TannerAWilliams/Senior-Design-Project/Rev2.1/cc2650_rev2-1_schematic.pdf

# Reset Button JTAG Connection

# MCU & Pins

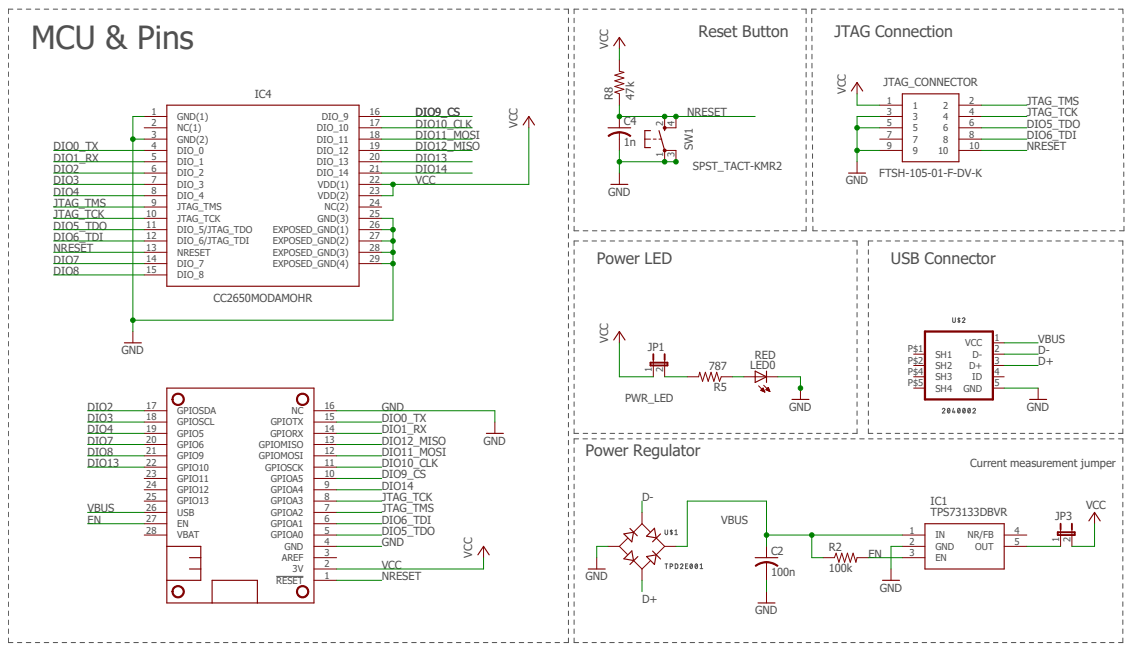
[picture p7: page 1]

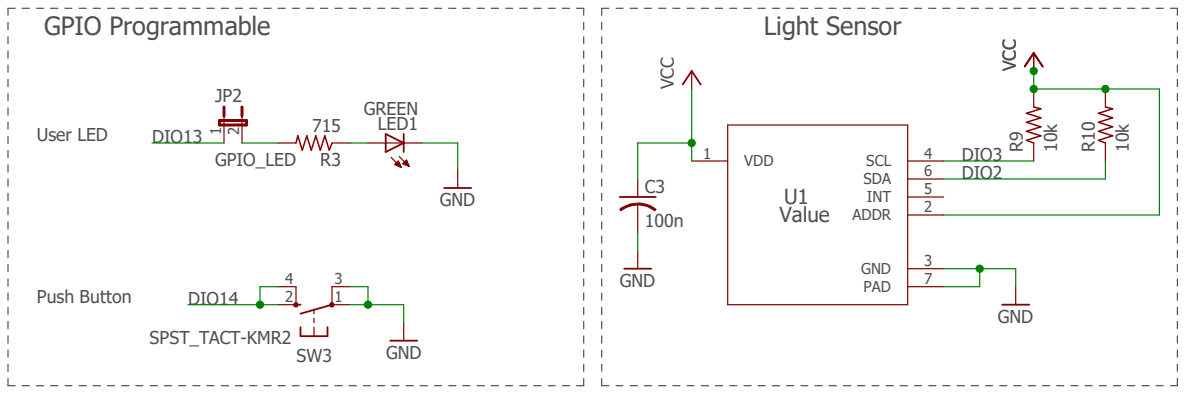
[picture p8: figure]
SPST_TACT-KMR2; GND; GPIO_LED; Value; GND VCC; VCC; GREEN; GPIO Programmable; User LED; Light Sensor; Push Button; VDD 1; ADDR; SCL; INT; 5 SDA; 6 PAD; LED1; R¹⁰; DIO14; DIO13; DIO3 DIO2
