TannerAWilliams/Senior-Design-Project/Rev1.2/cc2650_rev1-2_schematic.pdf

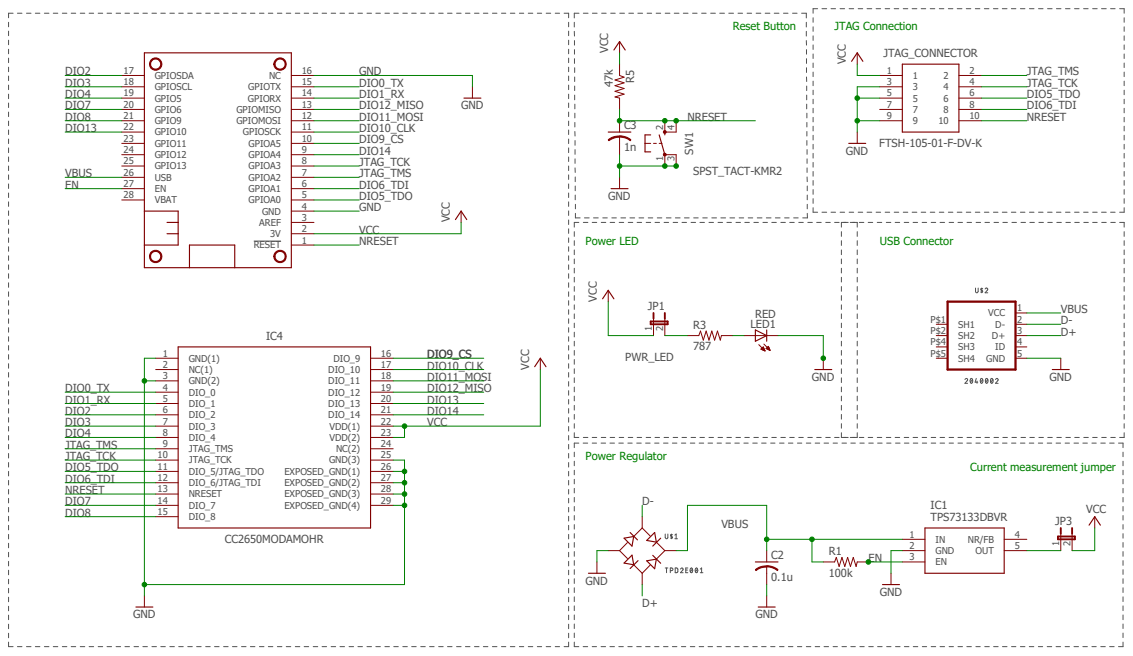
[picture p9: page 1]

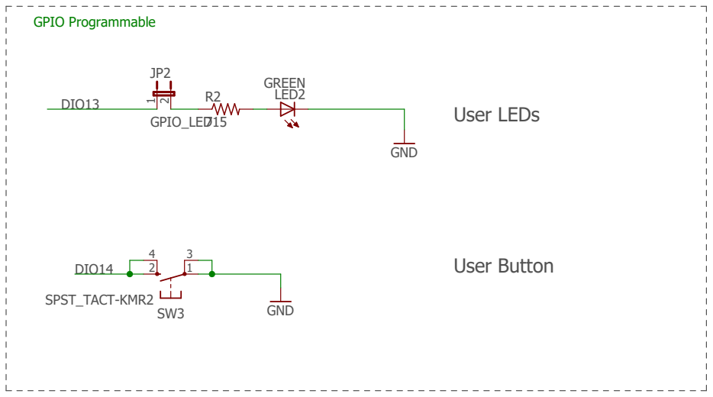
[picture p10: figure]
SPST_TACT-KMR2; GND; GREEN; GPIO_LED; User LEDs; User Button; LED2 1; DIO14; DIO13; GPIO Programmable
