TannerAWilliams/Senior-Design-Project/Rev1.0/cc2650_rev1_schematic.pdf

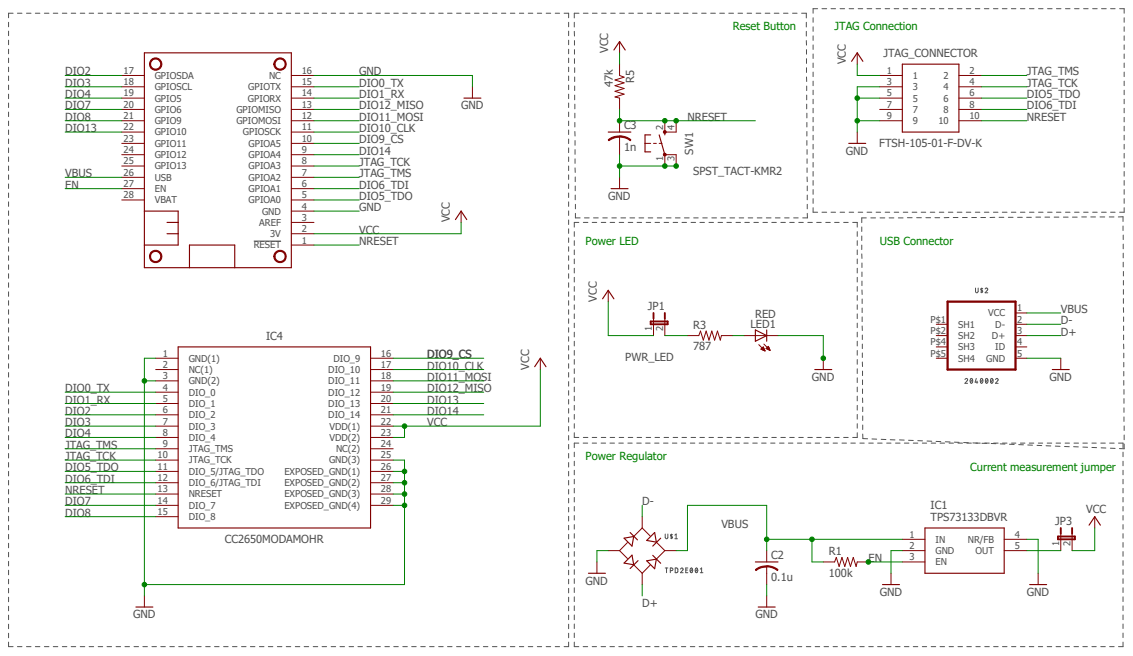
[picture p11: page 1]

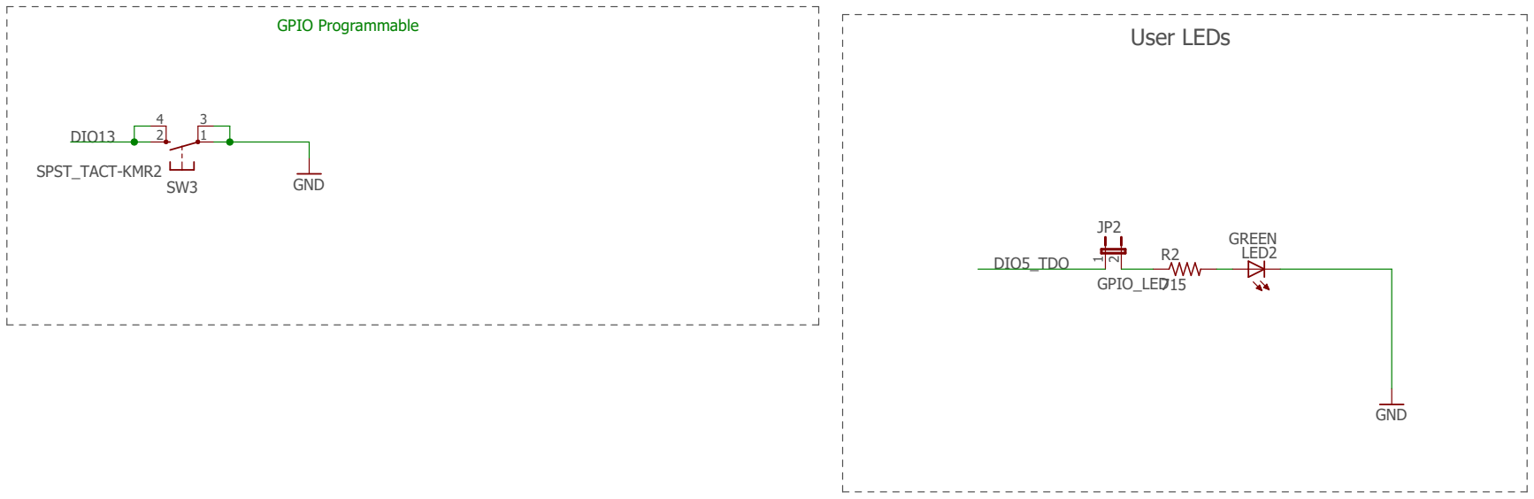
[picture p12: figure]
SPST_TACT-KMR2; GND; GREEN; GPIO_LED; User LEDs; LED2 1; DIO5_TDO; DIO13; GPIO Programmable
