TannerAWilliams/Senior-Design-Project/Rev1.1/cc2650_rev1-1_schematic.pdf

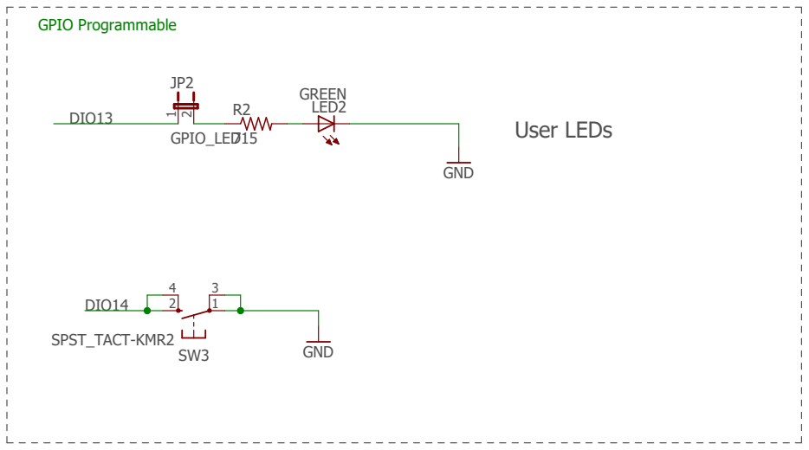
[picture p13: figure]
SPST_TACT-KMR2; GND; GREEN; GPIO_LED; User LEDs; LED2 1; DIO14; DIO13; GPIO Programmable
