TannerAWilliams/Senior-Design-Project/Rev1.2/cc2650_rev1-2.brd

## EAGLE design Rev1.2/cc2650_rev1-2.brd (2018-04-23, an earlier design)

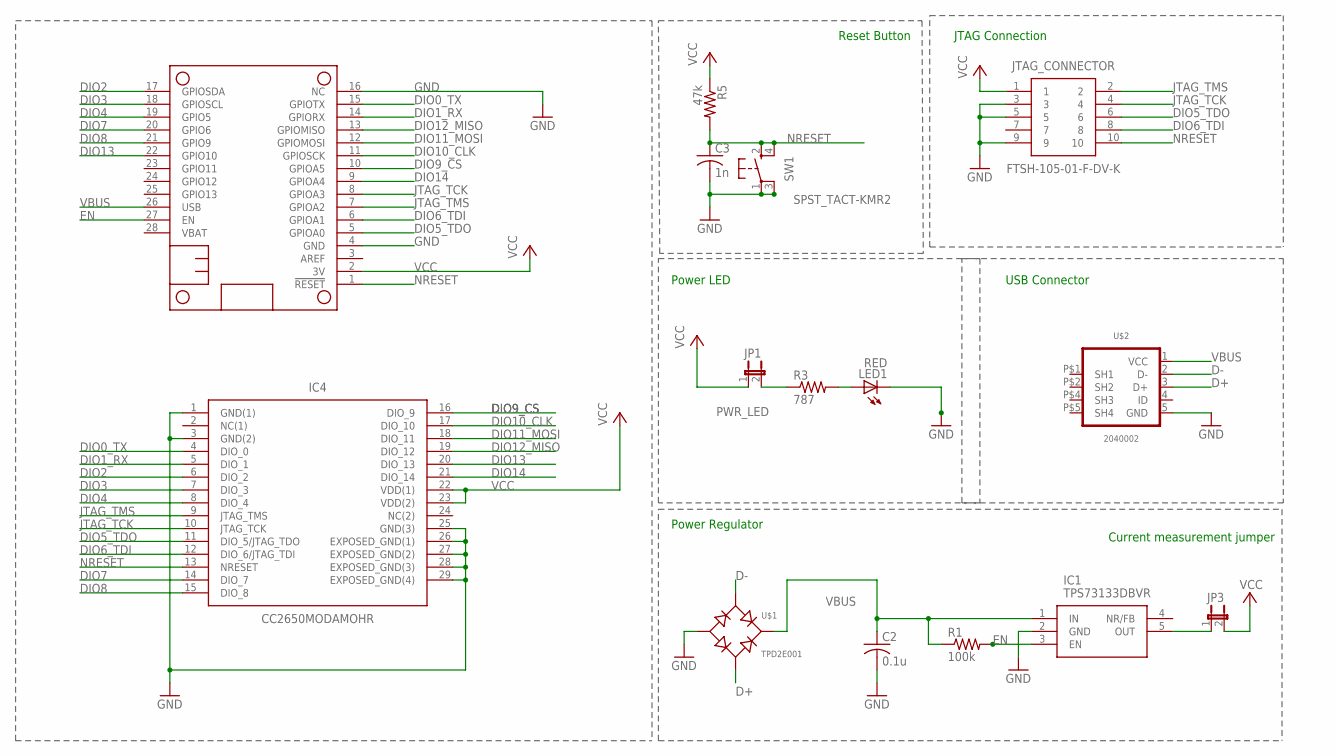
[picture p14: schematic cc2650_rev1-2.sch, sheet 1]

Parts:
C2: 0.1u; C1206; MPN VJ1206Y102KXBAC
C3: 1n; C1206; MPN VJ1206Y102KXBAC
IC1: TPS73133DBVR; SOT95P280X145-5N; MPN TPS73133DBVR
IC4: CC2650MODAMOHR; MOH0029A; MPN CC2650MODAMOHR
JP1, JP3: PWR_LED; JP1M; MPN 2211S-02G
JTAG_CONNECTOR: FTSH-105-01-F-DV-K; SAMTEC_FTSH-105-01-L-DV; MPN FTSH-105-01-F-DV-K
LED1: RED; CHIPLED_1206; MPN HSMC-C150
MS1: FEATHERWING_NODIM; FEATHERWING_DIM
R1: 100k; R1206; MPN CR1206-FX-4700ELF
R3: 787; R1206; MPN CR1206-FX-4700ELF
R5: 47k; R1206; MPN CRCW120647K0FKTA
SW1: SPST_TACT-KMR2; KMR2; MPN KMR241G LFS
U$1: TPD2E001; SOT-143
U$2: 2040002

Connections:
D+: U$1.3 (AC2), U$2.3 (D+)
D-: U$1.2 (AC1), U$2.2 (D-)
DIO0_TX: IC4.4 (DIO_0), MS1.15 (GPIOTX)
DIO1_RX: IC4.5 (DIO_1), MS1.14 (GPIORX)
DIO2: IC4.6 (DIO_2), MS1.17 (GPIOSDA)
DIO3: IC4.7 (DIO_3), MS1.18 (GPIOSCL)
DIO4: IC4.8 (DIO_4), MS1.19 (GPIO5)
DIO5_TDO: IC4.11 (DIO_5/JTAG_TDO), JTAG_CONNECTOR.6, MS1.5 (GPIOA0)
DIO6_TDI: IC4.12 (DIO_6/JTAG_TDI), JTAG_CONNECTOR.8, MS1.6 (GPIOA1)
DIO7: IC4.14 (DIO_7), MS1.20 (GPIO6)
DIO8: IC4.15 (DIO_8), MS1.21 (GPIO9)
DIO9_CS: IC4.16 (DIO_9), MS1.10 (GPIOA5)
DIO10_CLK: IC4.17 (DIO_10), MS1.11 (GPIOSCK)
DIO11_MOSI: IC4.18 (DIO_11), MS1.12 (GPIOMOSI)
DIO12_MISO: IC4.19 (DIO_12), MS1.13 (GPIOMISO)
DIO13: IC4.20 (DIO_13), MS1.22 (GPIO10); also elsewhere on the board
DIO14: IC4.21 (DIO_14), MS1.9 (GPIOA4); also elsewhere on the board
EN: IC1.3 (EN), MS1.27 (EN), R1.2
GND: C2.2, C3.2, IC1.2 (GND), IC4.1 (GND(1)), IC4.3 (GND(2)), IC4.25 (GND(3)), IC4.26 (EXPOSED_GND(1)), IC4.27 (EXPOSED_GND(2)), IC4.28 (EXPOSED_GND(3)), IC4.29 (EXPOSED_GND(4)), JTAG_CONNECTOR.3, JTAG_CONNECTOR.5, JTAG_CONNECTOR.9, LED1.C, MS1.4 (GND), MS1.16 (NC), SW1.1, SW1.3 (P1), U$1.1 (-), U$2.5 (GND); also elsewhere on the board
JTAG_TCK: IC4.10 (JTAG_TCK), JTAG_CONNECTOR.4, MS1.8 (GPIOA3)
JTAG_TMS: IC4.9 (JTAG_TMS), JTAG_CONNECTOR.2, MS1.7 (GPIOA2)
NRESET: C3.1, IC4.13 (NRESET), JTAG_CONNECTOR.10, MS1.1 (!RESET), R5.2, SW1.2 (S), SW1.4 (S1)
PWR_LED: LED1.A, R3.2
PWR_LED_JPR: JP1.2, R3.1
VBUS: C2.1, IC1.1 (IN), MS1.26 (USB), R1.1, U$1.4 (+), U$2.1 (VCC)
VCC: IC4.22 (VDD(1)), IC4.23 (VDD(2)), JP1.1, JP3.2, JTAG_CONNECTOR.1, MS1.2 (3V), R5.1
VCC_JPR: IC1.5 (OUT), JP3.1

Notes on the sheet:
Current measurement jumper
JTAG Connection
Reset Button
Power Regulator
Power LED
USB Connector

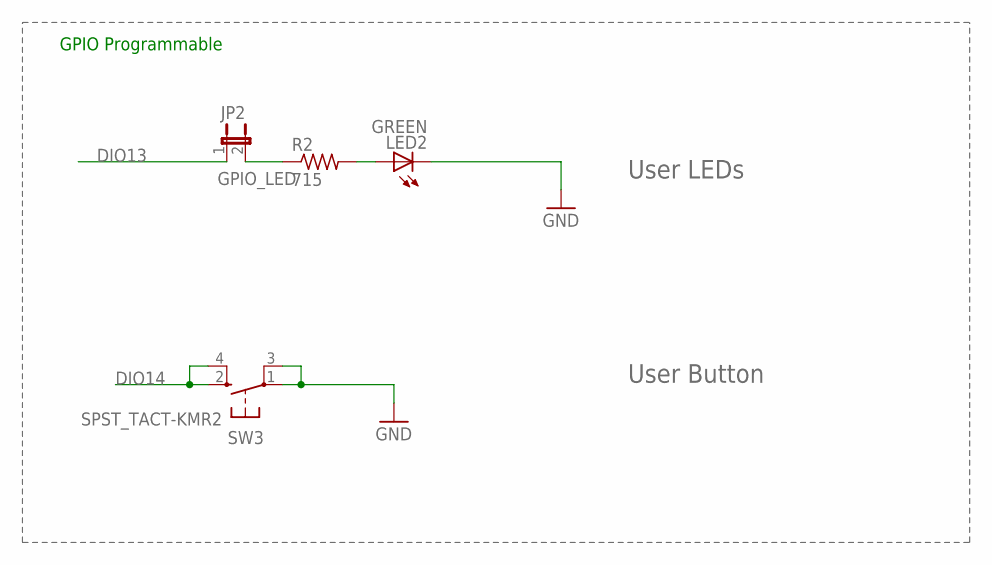
[picture p15: schematic cc2650_rev1-2.sch, sheet 2]

Parts:
JP2: GPIO_LED; JP1M; MPN 2211S-02G
LED2: GREEN; CHIPLED_1206; MPN HSMC-C150
R2: 715; R1206; MPN CR1206-FX-4700ELF
SW3: SPST_TACT-KMR2; KMR2; MPN KMR241G LFS

Connections:
DIO13: JP2.1; also elsewhere on the board
DIO14: SW3.2 (S), SW3.4 (S1); also elsewhere on the board
GND: LED2.C, SW3.1, SW3.3 (P1); also elsewhere on the board
GPIO_LED: LED2.A, R2.2
GPIO_LED_JPR: JP2.2, R2.1

Notes on the sheet:
GPIO Programmable
User LEDs
User Button

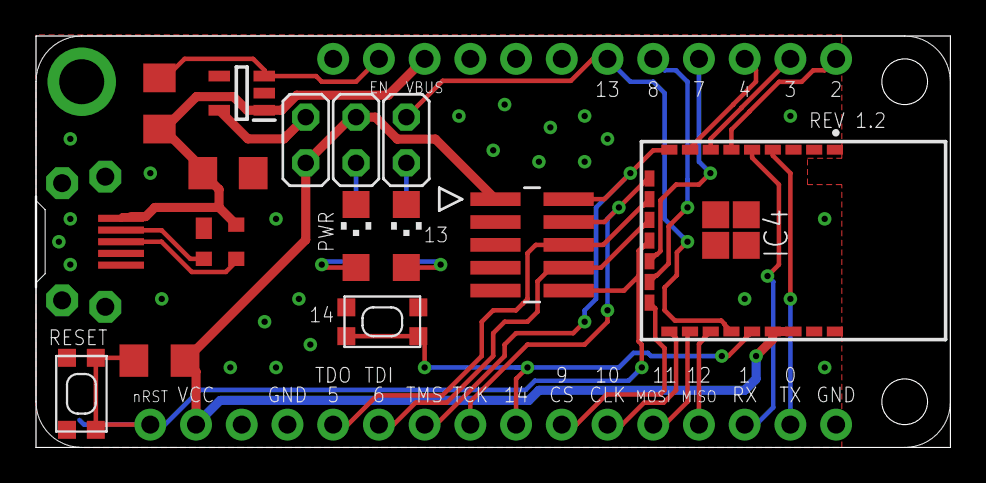
[picture p16: board cc2650_rev1-2.brd from above]

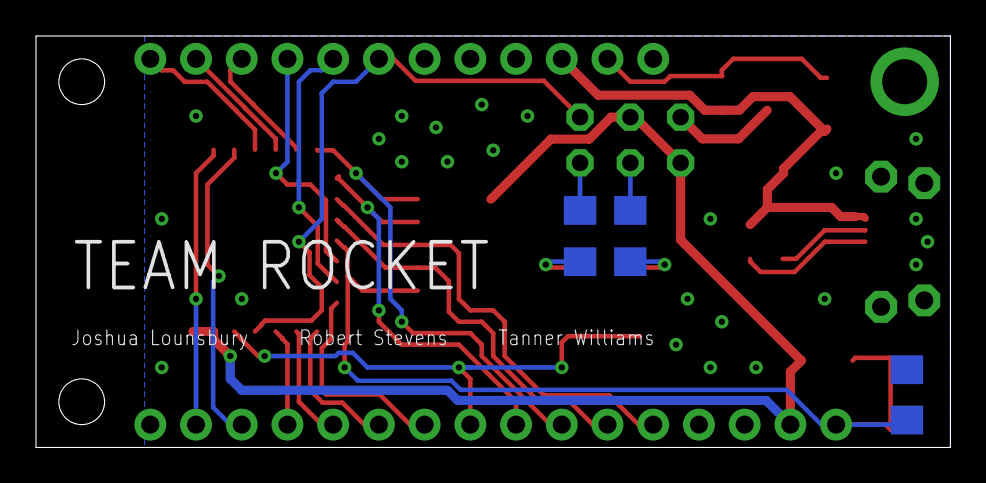
[picture p17: board cc2650_rev1-2.brd from below]

Board: 2 copper layers, 50.8 x 22.9 mm, 19 parts (3 on the bottom side), 29 nets.
