TannerAWilliams/Senior-Design-Project/Rev0/cc2650_simplified.brd

## EAGLE design Rev0/cc2650_simplified.brd (2017-11-17, an earlier design)

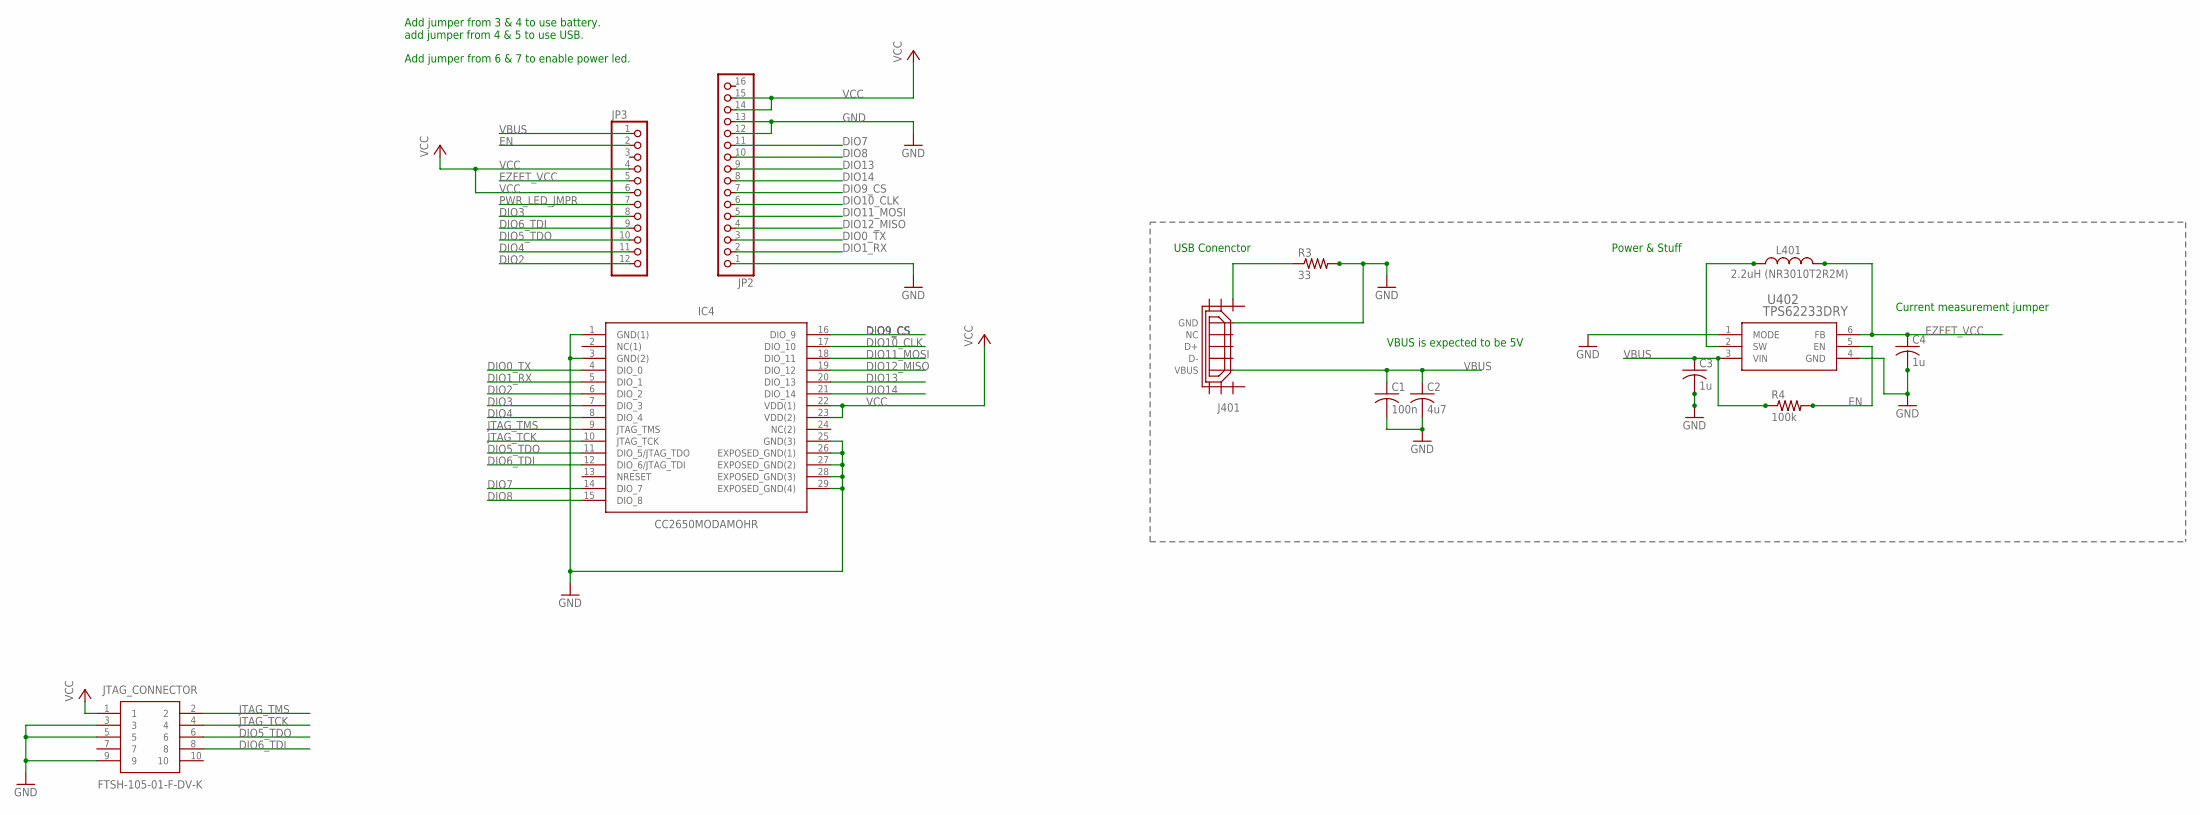
[picture p18: schematic cc2650_simplified.sch]

Parts:
C1: 100n; C0402; MPN C1005X7R1H104K050BB
C2: 4u7; C1206; MPN GRT31CC81E475KE01L
C3, C4: 1u; C0805; MPN C0805C105K5RACTU
IC4: CC2650MODAMOHR; MOH0029A; MPN CC2650MODAMOHR
J401: USB_MICRO_FLIPPED; HIROSE-ZX62R-B-5P; MPN ZX62R-B-5P(30)
JP2: HEADER-1X16ROUND; 1X16_ROUND
JP3: HEADER-1X12; 1X12_ROUND
JTAG_CONNECTOR: FTSH-105-01-F-DV-K; SAMTEC_FTSH-105-01-L-DV; MPN FTSH-105-01-F-DV-K
L401: 2.2uH (NR3010T2R2M); L-NR3010; MPN NR3010T2R2M
R3: 33; R0402; MPN ERJ-U02F33R0X
R4: 100k; R0603; MPN RC0603JR-07100KL
U402: TPS62233DRY; DRY6; MPN TPS62233DRYT

Connections:
DIO0_TX: IC4.4 (DIO_0), JP2.3
DIO1_RX: IC4.5 (DIO_1), JP2.2
DIO2: IC4.6 (DIO_2), JP3.12
DIO3: IC4.7 (DIO_3), JP3.8
DIO4: IC4.8 (DIO_4), JP3.11
DIO5_TDO: IC4.11 (DIO_5/JTAG_TDO), JP3.10, JTAG_CONNECTOR.6
DIO6_TDI: IC4.12 (DIO_6/JTAG_TDI), JP3.9, JTAG_CONNECTOR.8
DIO7: IC4.14 (DIO_7), JP2.11
DIO8: IC4.15 (DIO_8), JP2.10
DIO9_CS: IC4.16 (DIO_9), JP2.7
DIO10_CLK: IC4.17 (DIO_10), JP2.6
DIO11_MOSI: IC4.18 (DIO_11), JP2.5
DIO12_MISO: IC4.19 (DIO_12), JP2.4
DIO13: IC4.20 (DIO_13), JP2.9
DIO14: IC4.21 (DIO_14), JP2.8
EN: JP3.2, R4.2, U402.5 (EN)
EZFET_VCC: C4.1, JP3.5, L401.P$2 (2), U402.6 (FB)
GND: C1.2, C2.2, C3.2, C4.2, IC4.1 (GND(1)), IC4.3 (GND(2)), IC4.25 (GND(3)), IC4.26 (EXPOSED_GND(1)), IC4.27 (EXPOSED_GND(2)), IC4.28 (EXPOSED_GND(3)), IC4.29 (EXPOSED_GND(4)), J401.GND, JP2.1, JP2.12, JP2.13, JTAG_CONNECTOR.3, JTAG_CONNECTOR.5, JTAG_CONNECTOR.9, R3.2, U402.1 (MODE), U402.4 (GND)
JTAG_TCK: IC4.10 (JTAG_TCK), JTAG_CONNECTOR.4
JTAG_TMS: IC4.9 (JTAG_TMS), JTAG_CONNECTOR.2
unnamed: J401.SHIELD1, R3.1
unnamed: L401.P$1 (1), U402.2 (SW)
PWR_LED_JMPR: JP3.7
VBUS: C1.1, C2.1, C3.1, J401.VBUS, JP3.1, R4.1, U402.3 (VIN)
VCC: IC4.22 (VDD(1)), IC4.23 (VDD(2)), JP2.14, JP2.15, JP3.4, JP3.6, JTAG_CONNECTOR.1

Notes on the sheet:
USB Conenctor
Power & Stuff
VBUS is expected to be 5V
Current measurement jumper
Add jumper from 3 & 4 to use battery. add jumper from 4 & 5 to use USB.
Add jumper from 6 & 7 to enable power led.

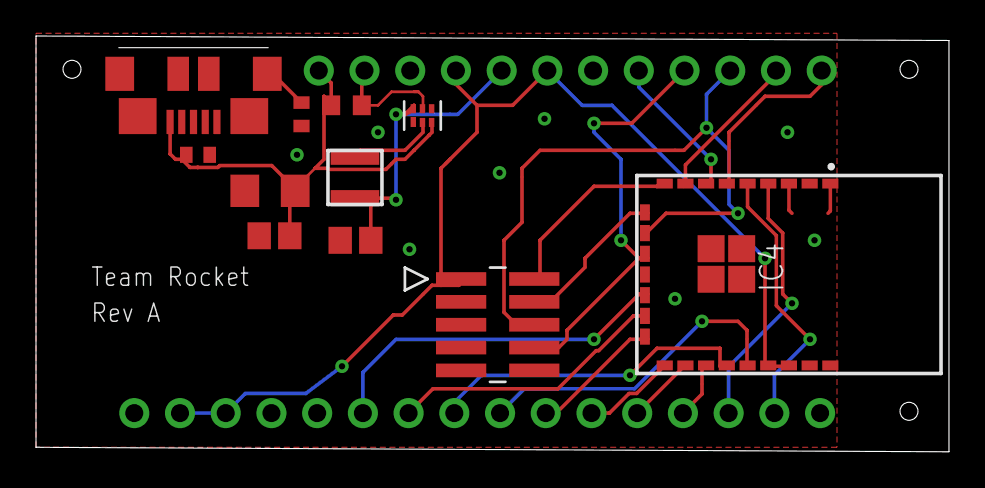
[picture p19: board cc2650_simplified.brd from above]

Board: 2 copper layers, 50.7 x 23.1 mm, 13 parts (1 on the bottom side), 24 nets.
