TannerAWilliams/Senior-Design-Project/(commit log)

2017-10-24 Adding Eagle Schematic and Board File
    [cc2650.brd, cc2650.sch]
2017-10-25 LED, pushbutton, battery ideas
    [cc2650.brd, cc2650.sch]
2017-10-29 made connections to 20 pin headers. added USB power connector.
    [cc2650.brd, cc2650.sch]
2017-10-30 added schematic provided by TI.
2017-10-30 reduced board size to match the feather and rearranged some components. Further space optimization is still needed.
    [cc2650.brd]
2017-11-02 Copied some parts from the LaunchPad example for posible replacement
    [cc2650.brd, cc2650.sch]
2017-11-02 Remove one of the 20 pin headers. Added some power components and connections.
    [cc2650.brd, cc2650.sch]
2017-11-03 added physical board assembly pdf.
2017-11-03 Changed a few connections and rearranged board layout.
    [cc2650.brd, cc2650.sch]
2017-11-03 Uploaded initial schematic and board layouts as pictures.
2017-11-03 created initial schematic and board layouts. Some additional connections required. use command 'RIPUP;' in board layout to erase ALL signal generated by autorouter.
    [cc2650.brd, cc2650.sch]
2017-11-03 Changed RGB LED.
    [cc2650.brd, cc2650.sch]
2017-11-10 changed pinout.
    [cc2650.brd, cc2650.sch]
2017-11-10 changed pinout and added second routing path.
    [cc2650.brd, cc2650.sch]
2017-11-10 changed usb connector
    [cc2650.brd, cc2650.sch]
2017-11-10 Changed USB connector. Fixed error.
    [cc2650.brd, cc2650.sch]
2017-11-10 removed jumpers for power and leds.
    [cc2650.brd, cc2650.sch]
2017-11-10 changed out battery to cc1220.
    [cc2650.brd, cc2650.sch]
2017-11-10 added routes
    [cc2650.brd]
2017-11-10 added routes. removed signal by antenna.
    [cc2650.brd]
2017-11-12 Added GND planes. Replaced some schematic symbols w/ US ones.
    [cc2650.brd, cc2650.sch]
2017-11-12 changed some pins. added bom through eagle.
    [cc2650.brd, cc2650.sch]
2017-11-12 added bom though eagle. added gnd planes. replaced some symbols.
    [cc2650.brd, cc2650.sch]
2017-11-12 added bom though eagle. added gnd planes. rearranged board.
    [cc2650.brd, cc2650.sch]
2017-11-13 changed 100k resistor to in stock.
2017-11-13 added connections for RGB LED and push button.
    [cc2650.brd, cc2650.sch]
2017-11-13 added board routing. 20 vias total.7 connect gnd planes.
    [cc2650.brd]
2017-11-13 modified board routing. 21 vias total. 8 connect gnd planes.
    [cc2650.brd]
2017-11-14 fixed gnd connection on USB.
    [cc2650.brd]
2017-11-14 minor routing changes.
    [cc2650.brd]
2017-11-16 Simplified board so far. Need to look at ground issue.
    [cc2650_simplified.brd, cc2650_simplified.sch]
2017-11-16 Changed Voltage Regulator to 3.3V output.
    [cc2650_simplified.brd, cc2650_simplified.sch]
2017-11-17 fixed broken connection and missing via.
    [cc2650_simplified.brd]
2017-11-17 fixed minor connections.
    [cc2650_simplified.brd]
2017-11-17 moved headers & usb away from edge of board
    [cc2650_simplified.brd]
2017-11-17 board size, gerber files
    [cc2650_simplified.brd]
2017-11-17 fixed silkscreen
    [cc2650_simplified.brd]
2017-11-17 added gerber files
2017-11-17 fixed 1 wire and silkscreen
    [cc2650_simplified.brd]
2017-12-07 added 48 pin cc2650. change R&C to bigger packages.
    [cc2650_48.brd, cc2650_48.sch]
2017-12-07 added 48 pin cc2650. change res, cap, led to bigger packages. moved battery to bottom of board. changed micro usb.
    [cc2650_48.brd, cc2650_48.sch]
2018-01-19 Unwanted files
    [cc2650_48.brd, cc2650_48.sch]
2018-01-22 Removed battery, ripped up connections to move things around and add sensors. Need to replace usb with through hole connector.
    [cc2650.brd, cc2650.sch]
2018-01-29 Added light sensor.
    [cc2650.brd, cc2650.sch]
2018-01-31 Switched out USB connector.
    [cc2650.brd, cc2650.sch]
2018-01-31 Changed position of holes, fixed dimensions.
    [cc2650.brd, cc2650.sch]
2018-01-31 Changred USB connector to TH.
    [cc2650.brd, cc2650.sch]
2018-02-02 Added light sensor connections.
    [cc2650.brd, cc2650.sch]
2018-02-02 Changed the pins for the light sensor connection.
    [cc2650.brd, cc2650.sch]
2018-02-07 added dimension on layer 47 (measure)
    [cc2650.brd]
2018-02-07 added new power regulator to schematic.
    [cc2650.brd, cc2650.sch]
2018-02-07 added coin cell from adafruit. added holes and RGB LED from MSP432.
    [cc2650.brd, cc2650.sch]
2018-02-07 re-arranged schematic.
    [cc2650.brd, cc2650.sch]
2018-02-08 changed R & C size to 1206. may need to consider 0805.
    [cc2650.brd, cc2650.sch]
2018-02-08 changed top gnd plane under cc2650 under RF test pads.
    [cc2650.brd]
2018-02-08 changed headers arrangement.
    [cc2650.brd, cc2650.sch]
2018-02-08 rearranged some components.
    [cc2650.brd, cc2650.sch]
2018-02-09 Moved around some parts.
    [cc2650.brd]
2018-02-14 Got rid of text.
    [cc2650.brd, cc2650.sch]
2018-02-14 moved some components to bottom side of the board.
    [cc2650.brd, cc2650.sch]
2018-02-14 changed btn pin from DIO4 -> DIO14. Rotated/moved res.
    [cc2650.brd, cc2650.sch]
2018-02-15 completed BOM through eagle. RGB led not in eagle choices. 12 & 16 pin headers chosen as signle adafruit feather pin kit.
    [cc2650.brd, cc2650.sch]
2018-02-16 added 100k res between EN and VBUS and added EN to pin headers. Changed coin cell holder to external connector.
    [cc2650.brd, cc2650.sch]
2018-02-16 switched usb and battery connection to match real feather layout. moved some other components to compensate.
    [cc2650.brd]
2018-02-20 modified adafruit FeatehrWing pin part to remove bottom left hole. Swapped modified FeatherWing for the 1x12 & 1x16 pin headers.
    [cc2650.brd, cc2650.sch]
2018-02-22 removed RGB LED. Removed extra power pins from pin headers.
    [cc2650.brd, cc2650.sch]
2018-02-22 changed resistor values for LEDS.
    [cc2650.brd, cc2650.sch]
2018-02-23 changed power circuitry
    [cc2650.brd, cc2650.sch]
2018-02-23 Changed power circuitry. Added TI ESD Suppresor.
    [cc2650.brd, cc2650.sch]
2018-02-25 changed usb to AMP lab part.
    [cc2650.brd, cc2650.sch]
2018-02-25 changed USB circuit to closer match layout of AMP card.
    [cc2650.brd, cc2650.sch]
2018-02-25 rearranged some components and hand routed some power signals.
    [cc2650.brd]
2018-02-26 routed everything but light sensor
    [cc2650.brd, cc2650.sch]
2018-02-26 added one missed VCC connection
    [cc2650.brd]
2018-02-26 fixed a few missing connections.
    [cc2650.brd]
2018-02-26 fixed a few missing connection to gnd on resistor in bottomw left.
    [cc2650.brd]
2018-02-26 fixed a connection on D-.
    [cc2650.brd]
2018-02-26 changed minor things based of feedback from Dz-Da Sung.
    [cc2650.brd, cc2650.sch]
2018-02-27 hand routed wires at 10 MIL and power at 20 MIL. still one issue in DRC with VBUS wire on USB. Cleaned up schematic to make things more compact.
    [cc2650.brd, cc2650.sch]
2018-02-27 fixed issue with VBUS on usb in DRC.
    [cc2650.brd]
2018-02-27 added some silk screen
    [cc2650.brd]
2018-02-27 added silkscreen to all pins.
    [cc2650.brd]
2018-02-27 changed silkscreen text size to .24
    [cc2650.brd]
2018-02-27 added more vias to gnd planes and REV 1.0
    [cc2650.brd]
2018-02-27 added a few more vias
    [cc2650.brd]
2018-03-20 added archive of rev1
    [cc2650_rev1.brd, cc2650_rev1.sch]
2018-03-20 removed gnd plane vias.
    [cc2650.brd]
2018-03-20 rearranged gpio LEDs and button. moved JATG connector to center of board.
    [cc2650.brd, cc2650.sch]
2018-03-20 moved some silkscreen. made size consistant.
    [cc2650.brd]
2018-03-20 changed silkscreen around LED/button. Added names to back side of board.
    [cc2650.brd]
2018-03-20 moved gpio button down from LEDs. reduced 'Team Rocket' font size on back so it doesn't interfere with resistors on back.
    [cc2650.brd]
2018-03-20 added extra gnd plane vias
    [cc2650.brd]
2018-03-20 removed one silkscreen object on backside.
    [cc2650.brd]
2018-03-20 added archive of rev 1.1.
    [cc2650_rev1-1.brd, cc2650_rev1-1.sch]
2018-03-23 added light sensor to schematic, but not placed on board. Cleaned up text on schematic.
    [cc2650.brd, cc2650.sch]
2018-03-23 moved light sensor to board and added VCC connections.
    [cc2650.brd, cc2650.sch]
2018-03-23 Removed text from light sensor and changed sensor position.
    [cc2650.brd, cc2650.sch]
2018-03-23 changed resistors and LEDs to 0603, capacitors to 0805.
    [cc2650.brd, cc2650.sch]
2018-03-23 tweaked some component positions.
    [cc2650.brd, cc2650.sch]
2018-03-26 completed light sensor wire routing. TODO: clean up silk screen, increase R/C size to 1206 to use old parts.
    [cc2650.brd, cc2650.sch]
2018-03-26 changed component size to 1206 except LED circuits.
    [cc2650.brd, cc2650.sch]
2018-03-26 fixed missing connection on button.
    [cc2650.brd, cc2650.sch]
2018-03-26 cleaned up silkscreen. changed light sensor cap to 1206.
    [cc2650.brd, cc2650.sch]
2018-03-26 added extra vias to gnd planes
    [cc2650.brd]
2018-03-26 moved LED and button 13 & 14 silk screen. Changed DIO5, 6 silkcreen with TDI/TDO. Reduced 'TEAM ROCKET' text size.
    [cc2650.brd]
2018-03-26 reduced 'TEAM ROCKET' silkscreen size.
    [cc2650.brd]
2018-03-26 changed names silkscreen
    [cc2650.brd]
2018-03-26 added gerber files for rev 2.0
2018-03-26 added archive copy of rev 2.0
    [cc2650_rev2.brd, cc2650_rev2.sch]
2018-03-26 added pdf schematics
2018-03-29 fixed drill .txt file. added t\bvalues to silkscreen layers in CAM processor.
2018-04-04 software example that toggles LED with button press for board REV 1.0. Uses TI-RTOS.
2018-04-23 Added Rev 2.1 by removing GND signal on power regulator that was causing an issue.
    [cc2650_rev2-1.brd, cc2650_rev2-1.sch]
2018-04-23 Added Rev 1.2 by removing GND signal on power regulator that was causing an issue.
    [cc2650_rev1-2.brd, cc2650_rev1-2.sch]
2018-04-23 reuploaded schematic pdf with out time caption on bottom.
2018-04-23 added individual folders for each revision.
    [cc2650_simplified.brd, cc2650_simplified.sch]
2018-04-23 moved booster pack datasheet, schematic, and assembly pdf to sperate folder.
2018-04-23 removed file that was copied to folder
    [cc2650.brd, cc2650.sch]
2018-04-23 removed files that were copied to seperate folders.
    [cc2650_rev1-1.brd, cc2650_rev1-1.sch, cc2650_rev1-2.brd, cc2650_rev1-2.sch, cc2650_rev1.brd, cc2650_rev1.sch, cc2650_rev2-1.brd, cc2650_rev2-1.sch]
